ein-shved/AvrTimer/body/step/BaseCase.step

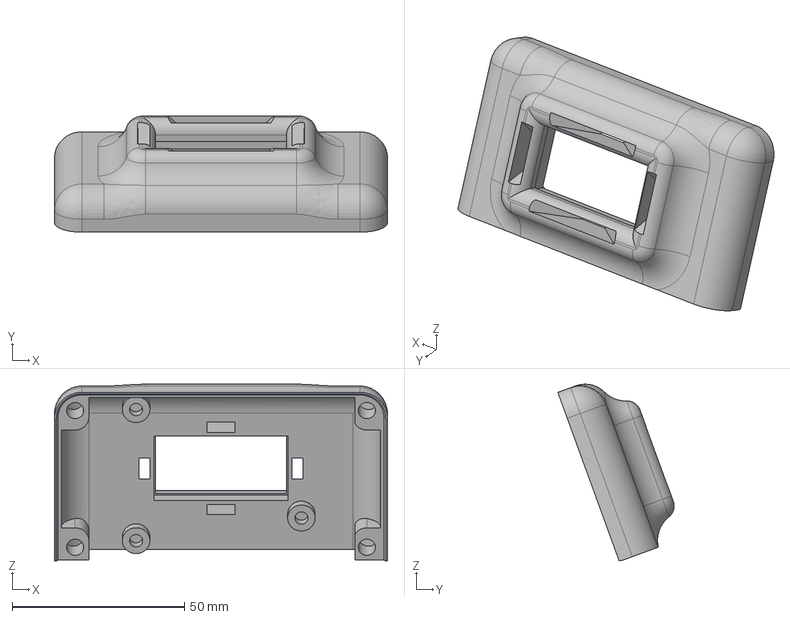
[picture p1: CAD file, 2022-10-24]
body/step/BaseCase.step
96.7 x 33.8 x 51.3 mm
