ein-shved/AvrTimer/body/step/MechCase.step

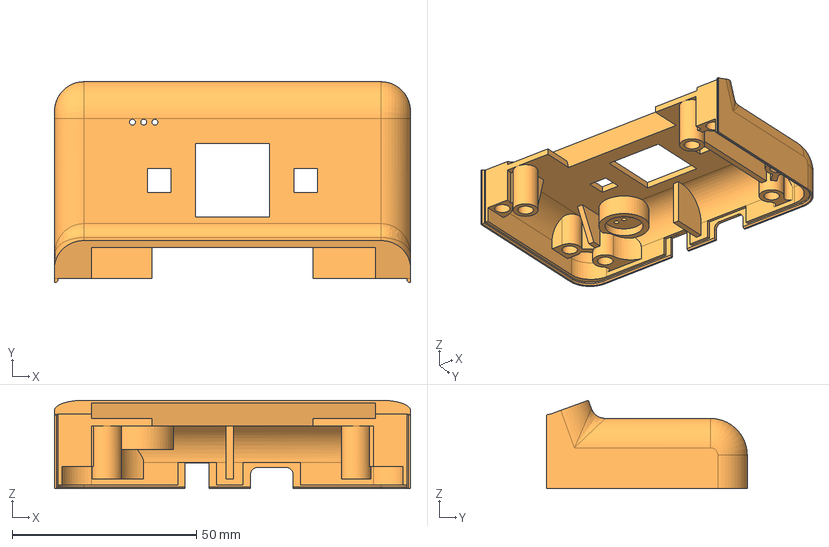
[picture p2: CAD file, 2022-10-24]
body/step/MechCase.step
96.7 x 54.5 x 24.0 mm
