ein-shved/AvrTimer/body/step/BaseLeg.step

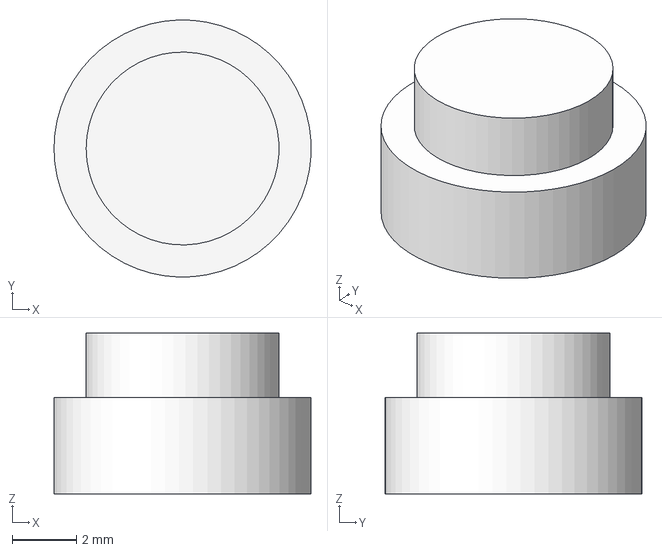
[picture p3: CAD file, 2022-10-24]
body/step/BaseLeg.step
7.99 x 8.00 x 5.00 mm
