ein-shved/AvrTimer/body/step/SmallButtonPlus.step

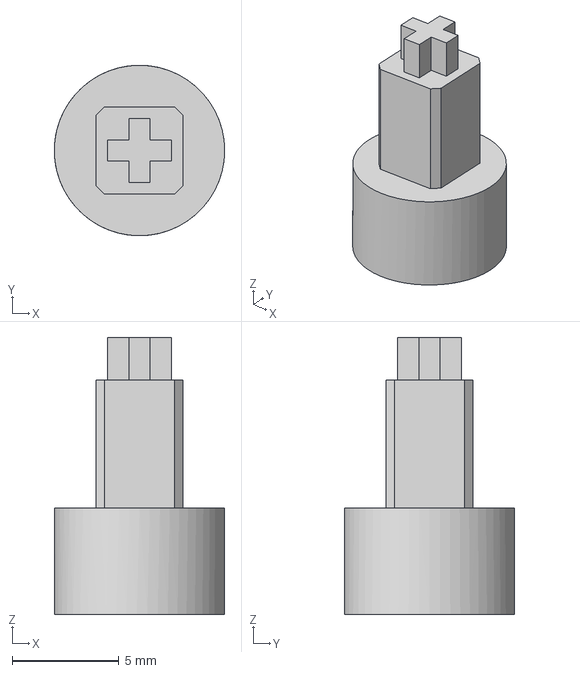
[picture p4: CAD file, 2022-10-24]
body/step/SmallButtonPlus.step
8.00 x 8.00 x 13.0 mm
