ein-shved/AvrTimer/body/step/BigButton.step

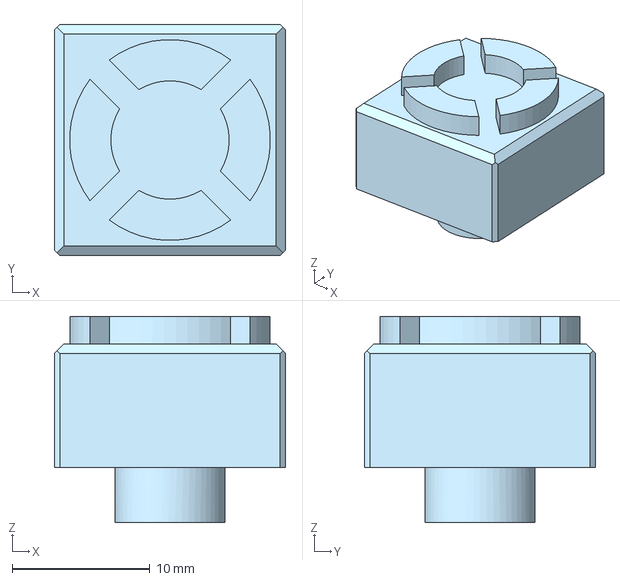
[picture p5: CAD file, 2022-10-24]
body/step/BigButton.step
16.8 x 16.8 x 15.0 mm
