ein-shved/AvrTimer/body/step/BackCase.step

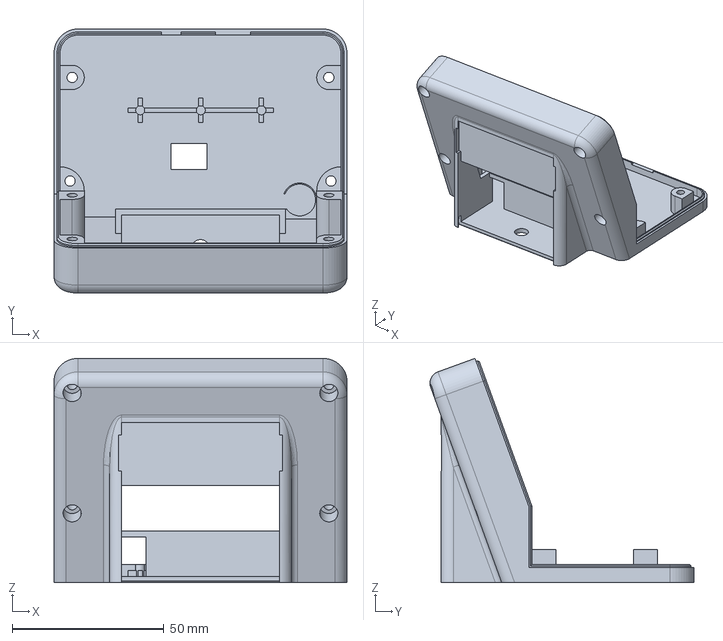
[picture p6: CAD file, 2022-10-24]
body/step/BackCase.step
96.7 x 87.1 x 74.0 mm
