ein-shved/AvrTimer/body/step/OpticalLong.step

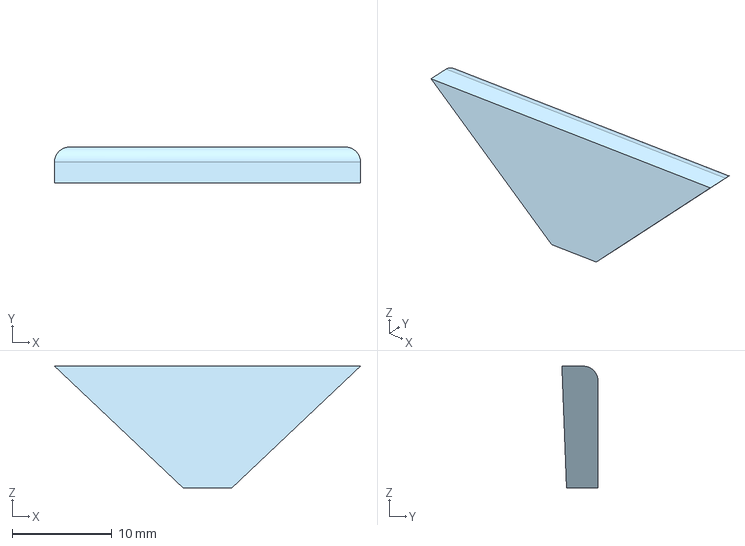
[picture p7: CAD file, 2022-10-24]
body/step/OpticalLong.step
30.7 x 3.63 x 12.2 mm
