ein-shved/AvrTimer/body/step/OpticalShort.step

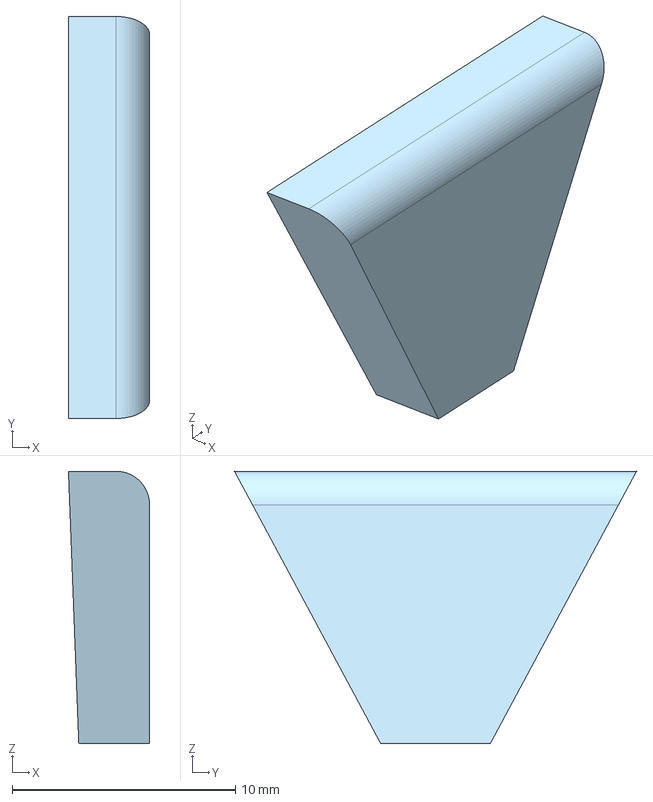
[picture p8: CAD file, 2022-10-24]
body/step/OpticalShort.step
3.63 x 18.0 x 12.2 mm
