ein-shved/AvrTimer/body/step/BatteryCover.step

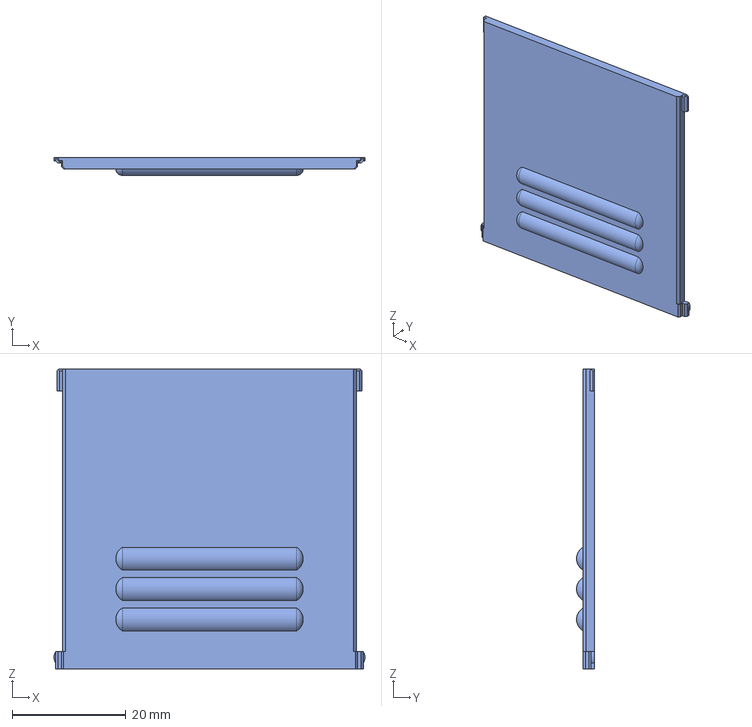
[picture p9: CAD file, 2022-10-24]
body/step/BatteryCover.step
54.6 x 3.15 x 52.6 mm
