ein-shved/AvrTimer/body/step/ButtonsFlex.step

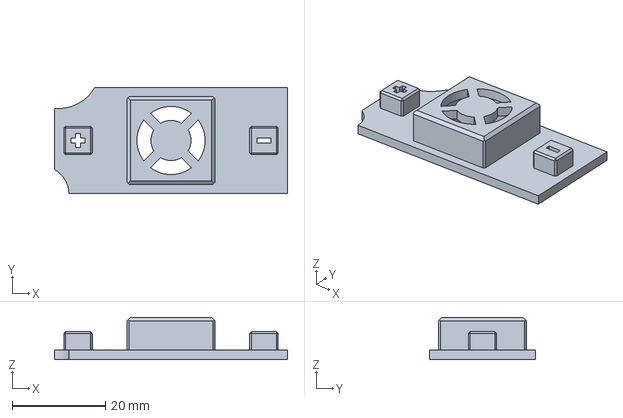
[picture p10: CAD file, 2022-10-24]
body/step/ButtonsFlex.step
49.9 x 22.8 x 9.00 mm
