ein-shved/AvrTimer/(list of files, cad)

Other CAD files:
body/step/SmallButtonMinus.step
body/stl/BackCase.stl
body/stl/BaseCase.stl
body/stl/BaseLeg.stl
body/stl/BatteryCover.stl
body/stl/BigButton.stl
body/stl/ButtonsFlex.stl
body/stl/MechCase.stl
body/stl/OpticalLong.stl
body/stl/OpticalShort.stl
body/stl/SmallButtonMinus.stl
body/stl/SmallButtonPlus.stl
