ein-shved/AvrTimer/pcb/mech/AvrTimer-Mech.kicad_pcb

## KiCad design pcb/mech/AvrTimer-Mech.kicad_pcb (2022-06-04)

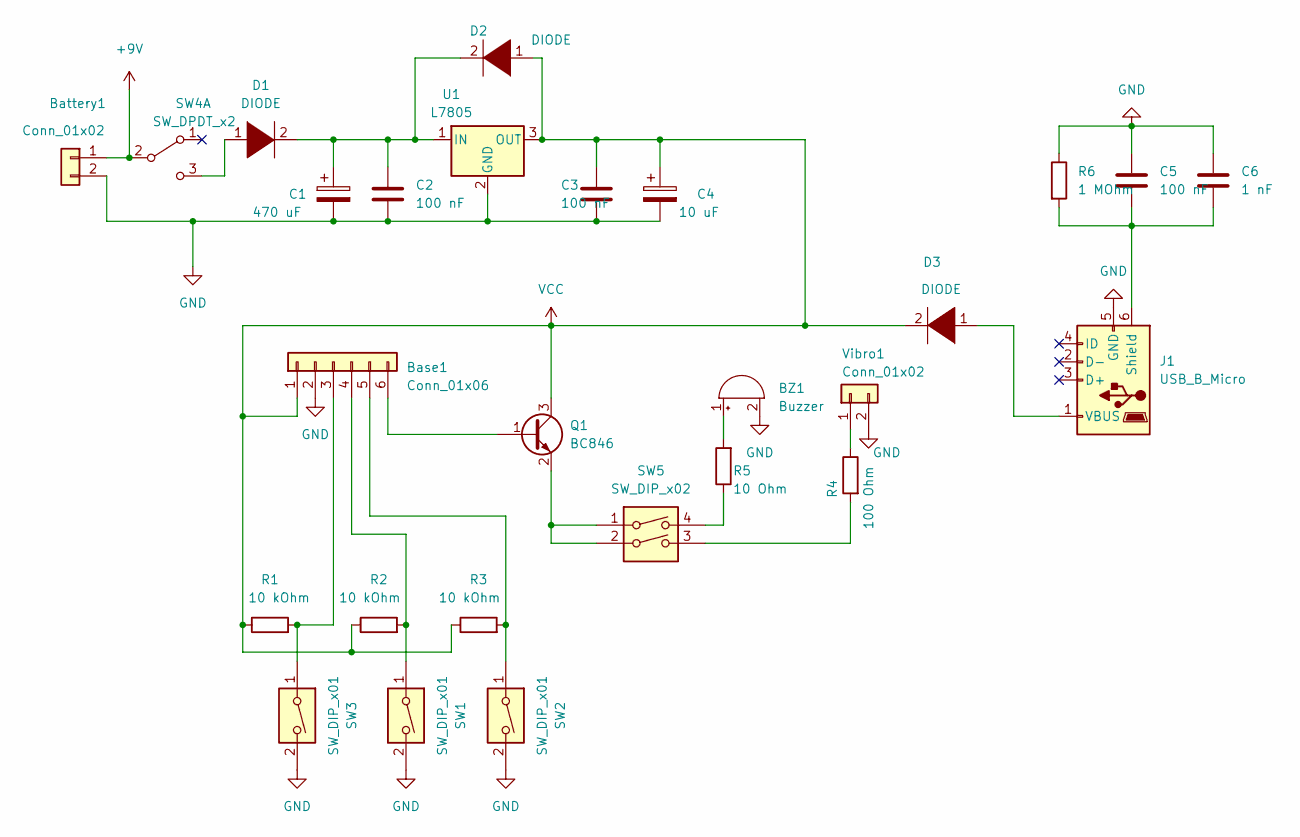
[picture p11: schematic AvrTimer-Mech.kicad_sch]

Parts:
BZ1: Buzzer; Buzzer_12x9.5RM7.6
Base1: Conn_01x06; JST_XH_B6B-XH-A_1x06_P2.50mm_Vertical
Battery1: Conn_01x02; JST_XH_B2B-XH-A_1x02_P2.50mm_Vertical
C1: 470 uF; CP_Radial_D10.0mm_P5.00mm
C2, C3, C5: 100 nF; C_0402_1005Metric_Pad0.74x0.62mm_HandSolder
C4: 10 uF; CP_Radial_D10.0mm_P5.00mm
C6: 1 nF; C_0402_1005Metric_Pad0.74x0.62mm_HandSolder
D1, D2, D3: DIODE; D_SOD-123F
J1: USB_B_Micro; USB_Micro-B_Molex_47346-0001
Q1: BC846; SOT-23
R1, R2, R3: 10 kOhm; R_1206_3216Metric_Pad1.30x1.75mm_HandSolder
R4: 100 Ohm; R_1206_3216Metric_Pad1.30x1.75mm_HandSolder
R5: 10 Ohm; R_1206_3216Metric_Pad1.30x1.75mm_HandSolder
R6: 1 MOhm; R_1206_3216Metric_Pad1.30x1.75mm_HandSolder
SW1: SW_DIP_x01; SW_PUSH-12mm
SW2, SW3: SW_DIP_x01; SW_PUSH_6mm
SW4: SW_DPDT_x2; L_KLS7_SS_12F19_G5
SW5: SW_DIP_x02; SW_DIP_SPSTx02_Slide_9.78x7.26mm_W7.62mm_P2.54mm
U1: L7805; TO-220-3_Horizontal_TabDown
Vibro1: Conn_01x02; JST_XH_B2B-XH-A_1x02_P2.50mm_Vertical

Connections:
+9V: Battery1.1, SW4.2 (B)
GND: BZ1.2 (+), Base1.2, Battery1.2, C1.2, C2.2, C3.2, C4.2, C5.1, C6.1, J1.5 (GND), R6.1, SW1.2, SW2.2, SW3.2, U1.2 (GND), Vibro1.2
unnamed: BZ1.1 (-), R5.2
unnamed: Base1.3, R1.2, SW3.1
unnamed: Base1.4, R2.2, SW1.1
unnamed: Base1.5, R3.2, SW2.1
unnamed: Base1.6, Q1.1 (B)
unnamed: C1.1, C2.1, D1.2 (A), D2.2 (A), U1.1 (IN)
unnamed: C5.2, C6.2, J1.6 (Shield), R6.2
unnamed: D1.1 (K), SW4.3 (C)
unnamed: D3.1 (K), J1.1 (VBUS)
unnamed: Q1.2 (E), SW5.1, SW5.2
unnamed: R4.1, Vibro1.1
unnamed: R4.2, SW5.3
unnamed: R5.1, SW5.4
VCC: Base1.1, C3.1, C4.1, D2.1 (K), D3.2 (A), Q1.3 (C), R1.1, R2.1, R3.1, U1.3 (OUT)

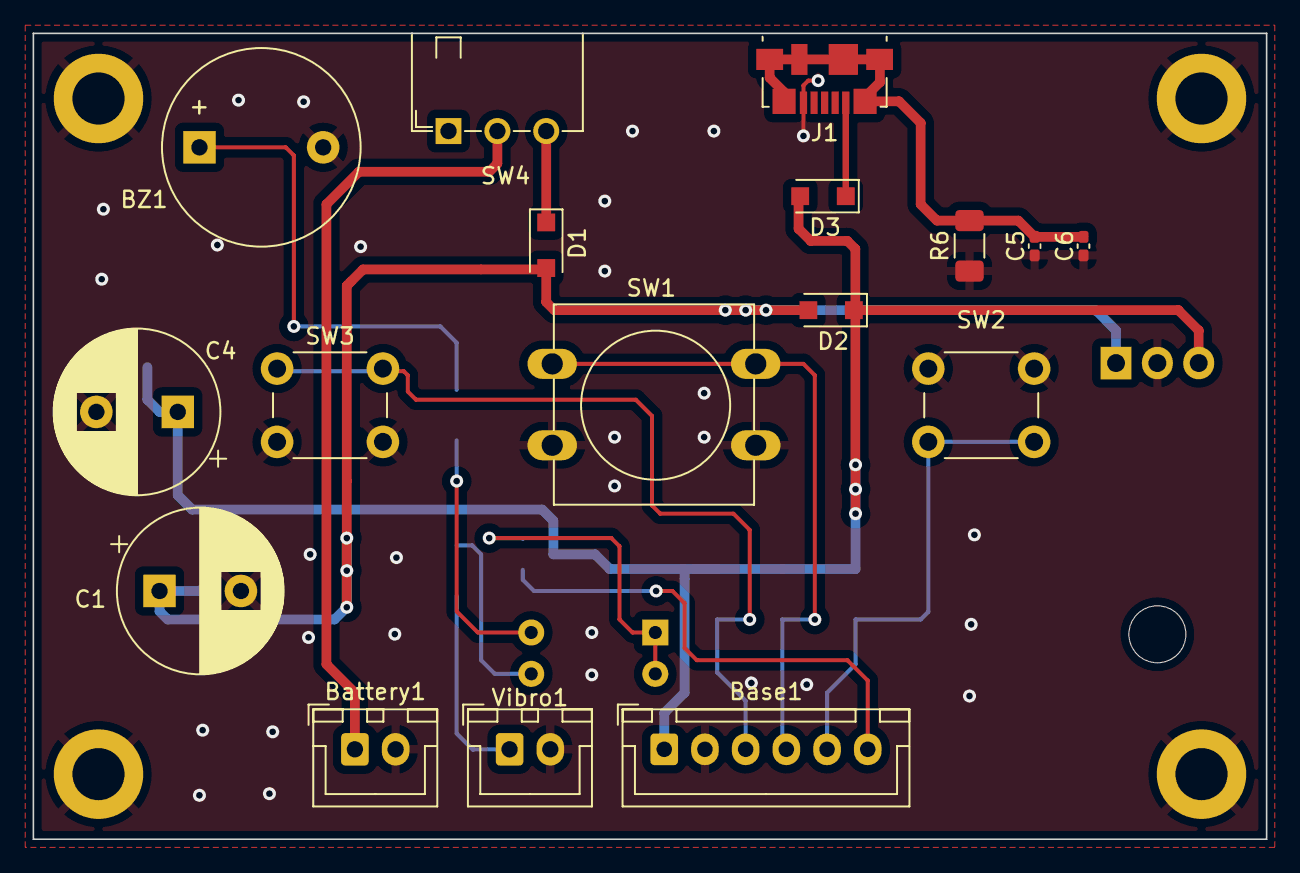
[picture p12: board AvrTimer-Mech.kicad_pcb from above]

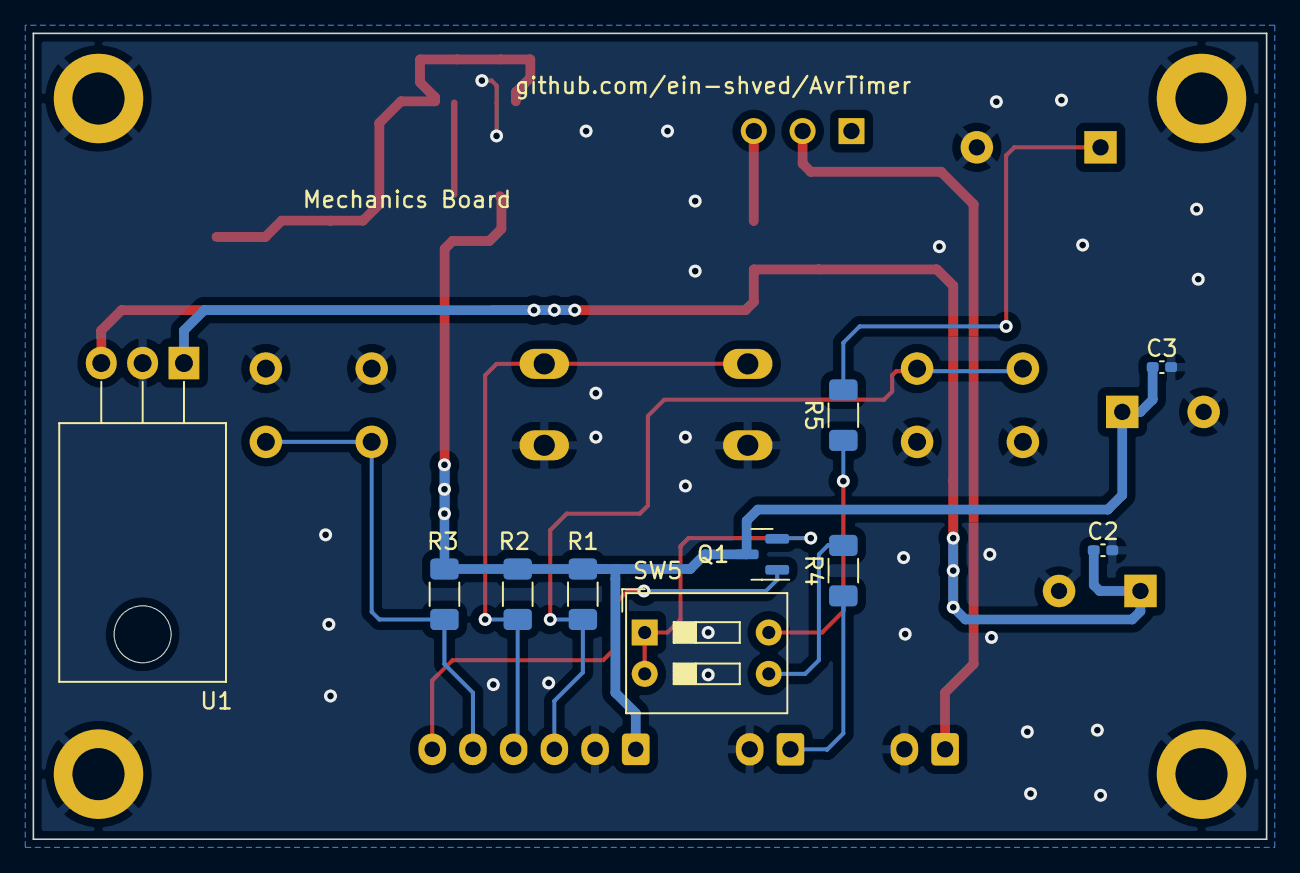
[picture p13: board AvrTimer-Mech.kicad_pcb from below]

Board: 2 copper layers, 75.8 x 49.5 mm, 27 parts (10 on the bottom side), 16 nets.
