ein-shved/AvrTimer/pcb/base/AvrTimer-Base.kicad_pcb

## KiCad design pcb/base/AvrTimer-Base.kicad_pcb (2022-04-24)

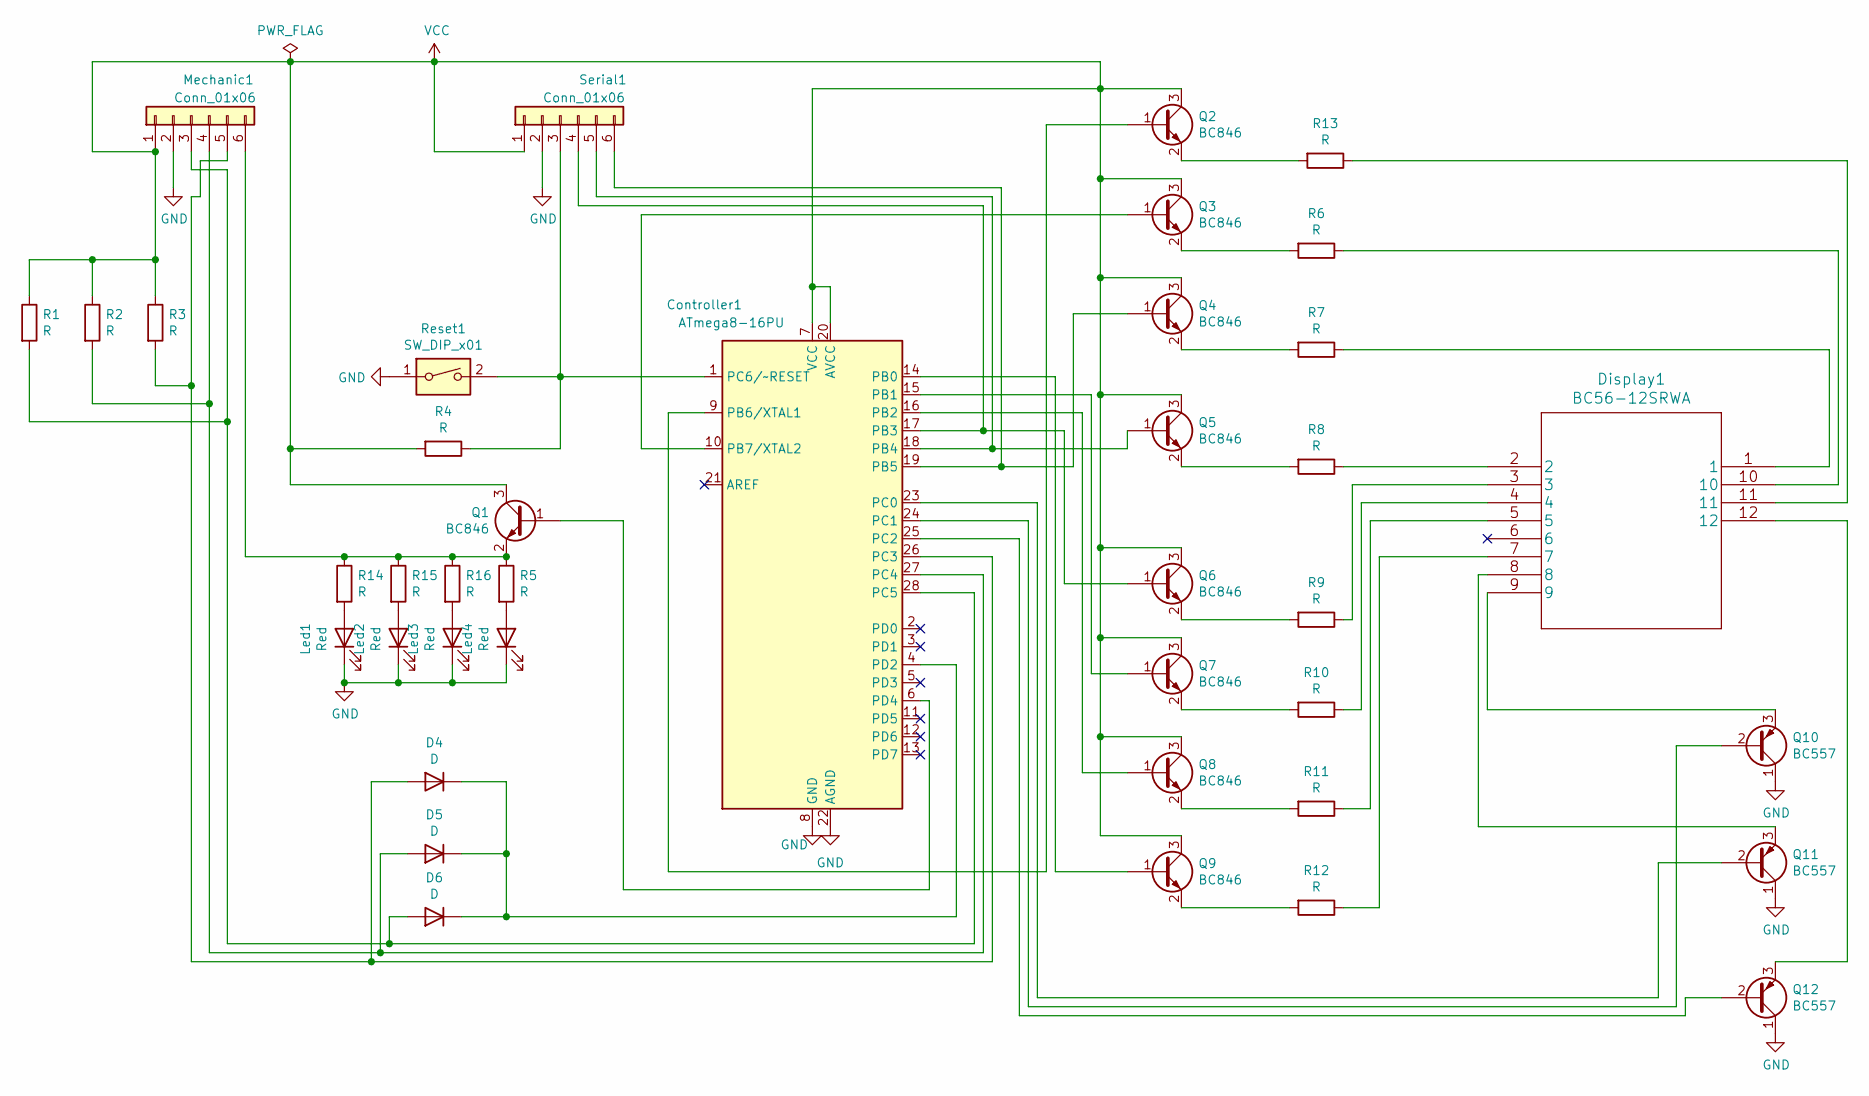
[picture p14: schematic AvrTimer-Base.kicad_sch, Avr Timer]

Parts:
Controller1: ATmega8-16PU; DIP-28_W7.62mm
D4, D5, D6: D; D_SOD-123F
Display1: BC56-12SRWA; BC56-12GWA
Led1, Led2, Led3, Led4: Red; LED_1210_3225Metric_Pad1.42x2.65mm_HandSolder
Mechanic1: Conn_01x06; JST_XH_B6B-XH-A_1x06_P2.50mm_Vertical
Q1, Q2, Q3, Q4, Q5, Q6, Q7, Q8, Q9: BC846; SOT-23_Handsoldering
Q10, Q11, Q12: BC557; SOT-23_Handsoldering
R1, R2, R3, R4, R5, R6, R7, R8, R9, R10, R11, R12, R13, R14, R15, R16: R; R_1206_3216Metric_Pad1.30x1.75mm_HandSolder
Reset1: SW_DIP_x01; SW_PUSH_6mm
Serial1: Conn_01x06; PinHeader_1x06_P2.54mm_Vertical

Connections:
GND: Controller1.8 (GND), Controller1.22 (AGND), Led1.1 (K), Led2.1 (K), Led3.1 (K), Led4.1 (K), Mechanic1.2, Q10.1 (C), Q11.1 (C), Q12.1 (C), Reset1.1, Serial1.2
unnamed: Controller1.1 (PC6/~RESET), R4.1, Reset1.2, Serial1.3
unnamed: Controller1.4 (PD2), D4.1 (K), D5.1 (K), D6.1 (K)
unnamed: Controller1.6 (PD4), Q1.1 (B)
unnamed: Controller1.9 (PB6/XTAL1), Q2.1 (B)
unnamed: Controller1.10 (PB7/XTAL2), Q3.1 (B)
unnamed: Controller1.14 (PB0), Q9.1 (B)
unnamed: Controller1.15 (PB1), Q7.1 (B)
unnamed: Controller1.16 (PB2), Q8.1 (B)
unnamed: Controller1.17 (PB3), Q6.1 (B), Serial1.4
unnamed: Controller1.18 (PB4), Q5.1 (B), Serial1.5
unnamed: Controller1.19 (PB5), Q4.1 (B), Serial1.6
unnamed: Controller1.23 (PC0), Q11.2 (B)
unnamed: Controller1.24 (PC1), Q10.2 (B)
unnamed: Controller1.25 (PC2), Q12.2 (B)
unnamed: Controller1.26 (PC3), D4.2 (A), Mechanic1.5, R3.2
unnamed: Controller1.27 (PC4), D5.2 (A), Mechanic1.4, R2.2
unnamed: Controller1.28 (PC5), D6.2 (A), Mechanic1.3, R1.2
unnamed: Display1.1, R7.1
unnamed: Display1.2, R8.1
unnamed: Display1.3, R9.1
unnamed: Display1.4, R10.1
unnamed: Display1.5, R11.1
unnamed: Display1.7, R12.1
unnamed: Display1.8, Q11.3 (E)
unnamed: Display1.9, Q10.3 (E)
unnamed: Display1.10, R6.1
unnamed: Display1.11, R13.1
unnamed: Display1.12, Q12.3 (E)
unnamed: Led1.2 (A), R14.2
unnamed: Led2.2 (A), R15.2
unnamed: Led3.2 (A), R16.2
unnamed: Led4.2 (A), R5.2
unnamed: Mechanic1.6, Q1.2 (E), R5.1, R14.1, R15.1, R16.1
unnamed: Q2.2 (E), R13.2
unnamed: Q3.2 (E), R6.2
unnamed: Q4.2 (E), R7.2
unnamed: Q5.2 (E), R8.2
unnamed: Q6.2 (E), R9.2
unnamed: Q7.2 (E), R10.2
unnamed: Q8.2 (E), R11.2
unnamed: Q9.2 (E), R12.2
VCC: Controller1.7 (VCC), Controller1.20 (AVCC), Mechanic1.1, Q1.3 (C), Q2.3 (C), Q3.3 (C), Q4.3 (C), Q5.3 (C), Q6.3 (C), Q7.3 (C), Q8.3 (C), Q9.3 (C), R1.1, R2.1, R3.1, R4.2, Serial1.1

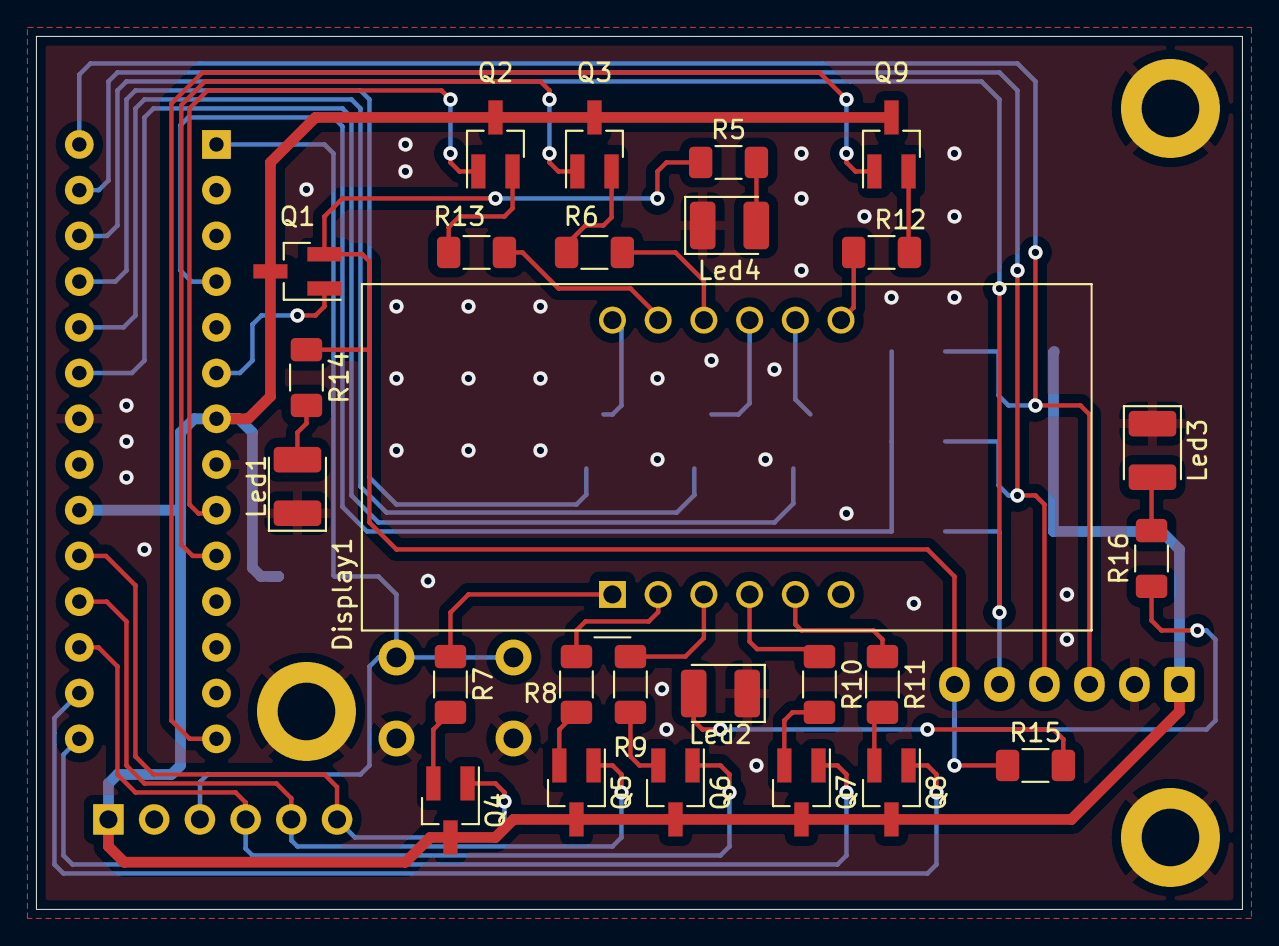
[picture p15: board AvrTimer-Base.kicad_pcb from above]

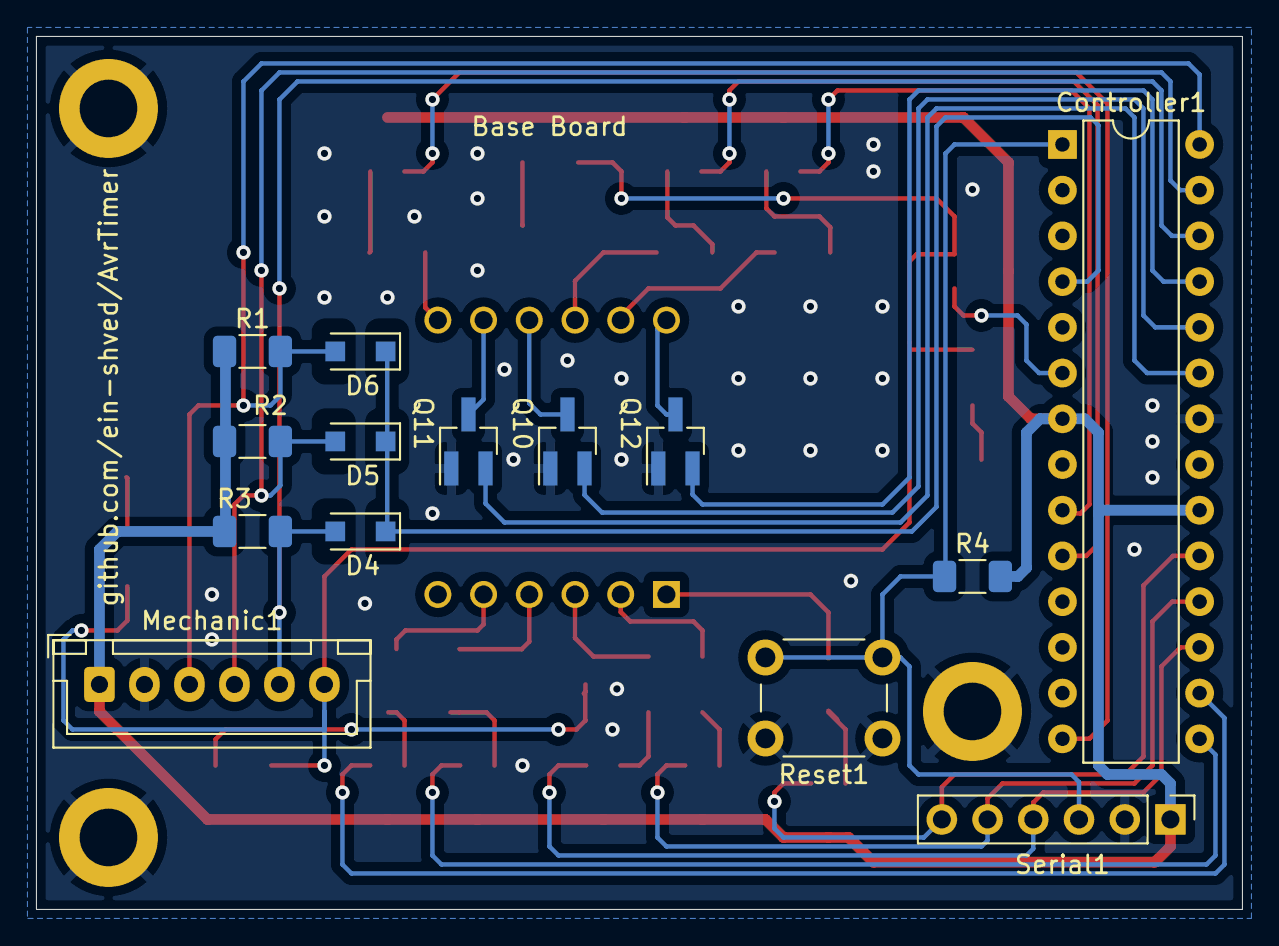
[picture p16: board AvrTimer-Base.kicad_pcb from below]

Board: 2 copper layers, 67.0 x 48.5 mm, 40 parts (14 on the bottom side), 43 nets.
