ein-shved/AvrTimer/(commit log)

2022-03-20 Initial commit
    This commit should be spited, but sorry.
    Here is:
    * Fsm, which handles ticking and configuring timer.
    * Printer, which direly controls display with 3 seven-segment digits.
    * Program buttons debouncing
    * Saving config to eeprom
    * Alarm withing extra pin
    Up to go:
    * Going to sleep.
    * PCB.
    * 3D-printable body.
2022-04-14 Add scheme and pcb for base board
    [AvrTimer.kicad_pcb, AvrTimer.kicad_sch, AvrTimer.sch]
2022-04-16 Partly update scheme for hand-soldering
    [AvrTimer.kicad_pcb, AvrTimer.kicad_sch]
2022-04-16 Update all footprints to correct ones
    [AvrTimer.kicad_pcb, AvrTimer.kicad_sch]
2022-04-19 Update after Alexander's Y. review
    [AvrTimer.kicad_pcb, AvrTimer.kicad_sch]
2022-04-21 Final version of base board
    [AvrTimer.kicad_pcb, AvrTimer.kicad_sch]
2022-04-21 Split project to subfolders
    [AvrTimer-Base.kicad_pcb, AvrTimer-Base.kicad_sch, AvrTimer-Base.sch]
2022-04-24 Add local pretty library
    Add source reference and board name o Base board
    [AvrTimer-Base.kicad_pcb, AvrTimer-Base.kicad_sch]
2022-04-24 Implement mechanics scheme and board
    [AvrTimer-Mech.kicad_pcb, AvrTimer-Mech.kicad_sch]
2022-04-24 Replace diode footprints to shop real ones
    [AvrTimer-Base.kicad_pcb, AvrTimer-Base.kicad_sch, AvrTimer-Mech.kicad_pcb, AvrTimer-Mech.kicad_sch]
2022-04-26 Update after Alexander's review
    [AvrTimer-Mech.kicad_pcb, AvrTimer-Mech.kicad_sch]
2022-06-04 [PCB] Add values for R and C
    [AvrTimer-Base.kicad_sch, AvrTimer-Mech.kicad_pcb, AvrTimer-Mech.kicad_sch]
2022-06-04 Fix segments placements for onboard setup
    Add special SEGMENT_X macro for handy digits definition
    Implement segments probe mode
    Fix hiding number
    Fix buttons and segments pins
    [fsm.c, printer.c, timer.h]
2022-10-24 Some fixes in printer with number hiding
    [printer.c]
2022-10-24 [body] Add *stl and *step files for body printing
    [BackCase.step, BackCase.stl, BaseCase.step, BaseCase.stl, BaseLeg.step, BaseLeg.stl, BatteryCover.step, BatteryCover.stl]
